c4tsnest/kicad_library/3dmodel/TPSM53602RDAR.step

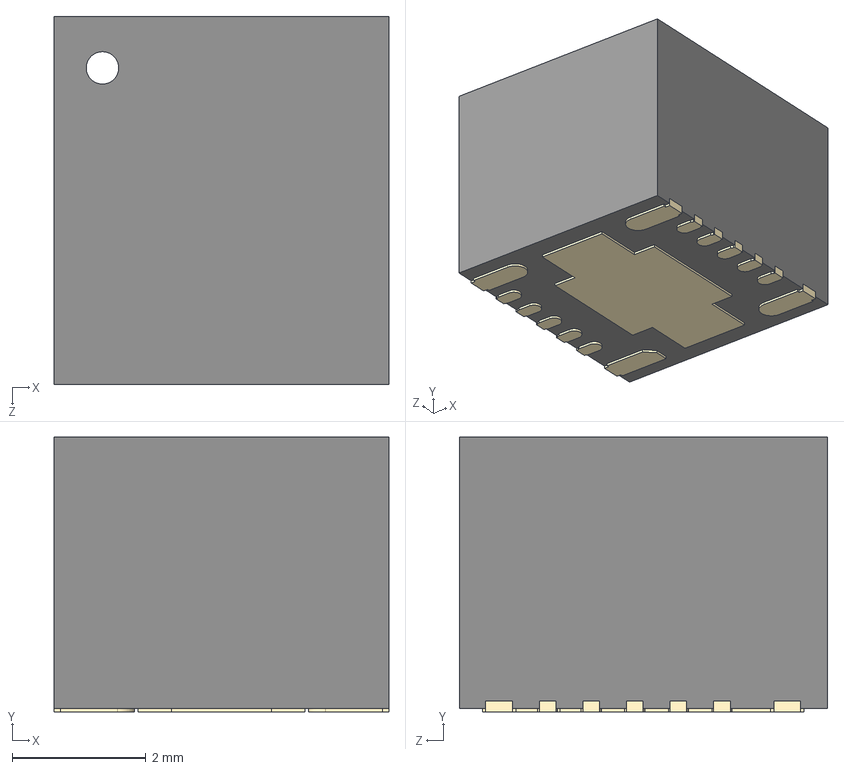
[picture p1: CAD file, 2025-08-31]
3dmodel/TPSM53602RDAR.step
5.00 x 4.10 x 5.50 mm
