c4tsnest/kicad_library/3dmodel/52991-0408.step

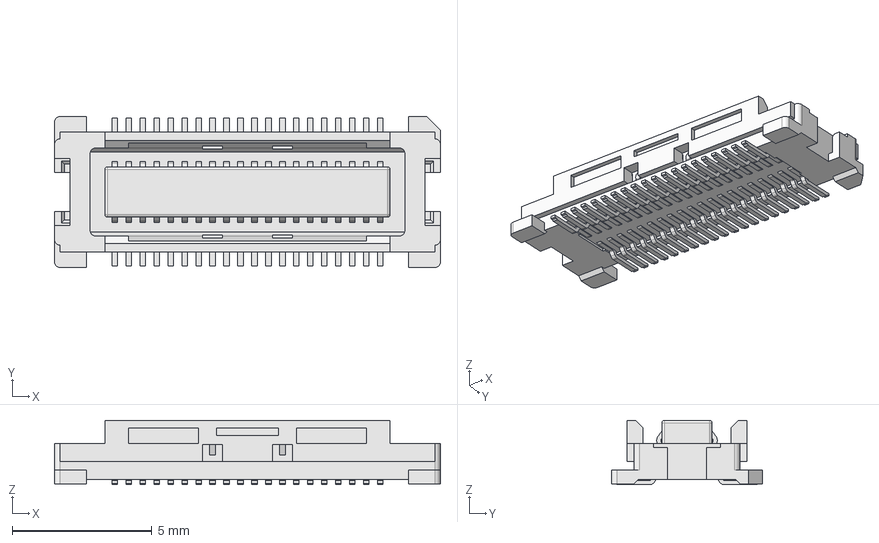
[picture p2: CAD file, 2025-08-31]
3dmodel/52991-0408.step
13.8 x 5.40 x 2.30 mm
